coon42/magic-lantern-dev-kit/README.md

# magic-lantern-dev-kit
A dev kit for connection and communication with the service port of Canon EOS cameras.
