coon42/magic-lantern-dev-kit/dev_board/bom.xlsx

Item | Quantity | Reference | Manufacturer | DigiKey Distrib. Part # | Description
 | 14 | C1, C2, C4, C6, C7, C8, C9, C10, C11, C12, C13, C14, C17, C18 |  | 399-1170-1-ND | 100nF
 | 2 | C3, C5 |  | 399-C0805C300M5HAC7800CT-ND | 30pF
 | 2 | C15, C16 |  | T491A475K006AT7280-ND | 4.7uF Tantalum
 | 3 | D1, D3, D5 |  | 350-2038-2-ND | Led Red
 | 2 | D2, D4 |  | 732-4986-1-ND | Led Green
 | 2 | FB1, FB2 |  | 445-1568-1-ND | 220R @ 100MHz
 | 1 | J1 |  | SAM12233-ND | 01x05 2.54mm pin header (JTAG)
 | 1 | J2 |  | 732-5395-ND | 02x04 2.54mm IDC header (service cable connector)
 | 1 | J3 |  | SAM8952-ND | USB B Mini
 | 1 | J4 |  | A122210-ND | 01x08 2.54mm pin header (Probe Connector)
 | 1 | J5 |  | 609-3486-2-ND | 02x08 2.54mm SMD pin header (Jumper terminal)
 | 1 | Q1 |  | IRLML5203TRPBFCT-ND | IRLML5203 P channel Mosfet (for status LED)
 | 4 | R1, R2, R3, R8 |  | 2019-RK73B2ATTD103JCT-ND | 10K
 | 1 | R4 |  | 2019-RK73B2ATTD223JCT-ND | 22K
 | 1 | R5 |  | 2019-RK73B2ATTD123JCT-ND | 12K
 | 3 | R6, R13, R15 |  | 2019-RK73H2ATTD1001FTR-ND | 1K
 | 1 | R7 |  | 2019-RK73B2ATTD104JCT-ND | 100K
 | 5 | R9, R10, R11, R12, R14 |  | 2019-RK73B2ATTD331JTR-ND | 330R
 | 2 | U1, U2 |  | 296-34900-1-ND | SN74AUP1T34DCK Logic Level Translator
 | 1 | U3 |  | 93LC56BT-I/OTCT-ND | 93LCxxBxxOT EEPROM
 | 1 | U4 |  | 497-1242-1-ND | LD1117S33TR_SOT223 3.3V linear regulator
 | 1 | U5 |  | 768-1026-1-ND | FT4232HL Quad FTDI
 | 1 | U6 |  | 296-23258-1-ND | 74HC595 shift register
 | 1 | Y1 |  | 887-1720-1-ND | 12Mhz crystal oscillator
