coon42/magic-lantern-dev-kit/dev_board/ml_dev_board.kicad_pcb

## KiCad design dev_board/ml_dev_board.kicad_pcb (2026-02-09)

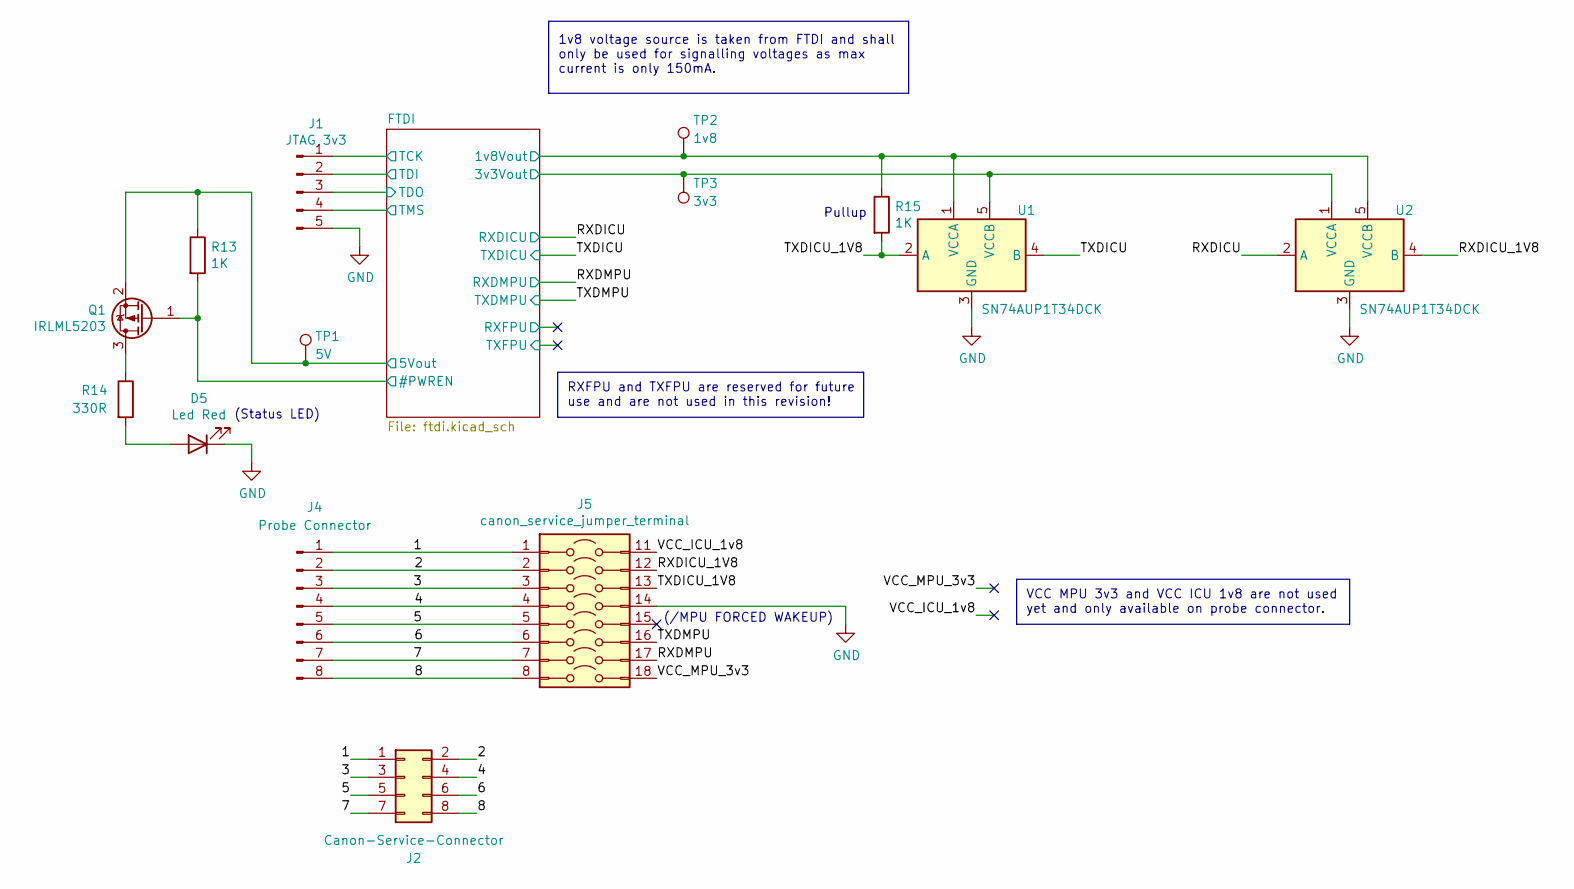
[picture p1: schematic ml_dev_board.kicad_sch]

Parts:
D5: Led Red; LED_0805_2012Metric
J1: JTAG 3v3; PinHeader_1x05_P2.54mm_Vertical_SMD_Pin1Left
J2: Canon-Service-Connector; IDC-Header_2x04_P2.54mm_Vertical
J4: Probe Connector; PinHeader_1x08_P2.54mm_Vertical_SMD_Pin1Left
J5: canon_service_jumper_terminal; PinHeader_2x08_P2.54mm_Vertical_Jumper_SMD
Q1: IRLML5203; SOT-23
R13, R15: 1K; R_0805_2012Metric
R14: 330R; R_0805_2012Metric
TP1: 5V; TestPoint_Pad_D1.5mm
TP2: 1v8; TestPoint_Pad_D1.5mm
TP3: 3v3; TestPoint_Pad_D1.5mm
U1, U2: SN74AUP1T34DCK; SOT-353_SC-70-5

Connections:
+1V8: R15.1, TP2.1, U1.1 (VCCA), U2.5 (VCCB); also elsewhere on the board
+3V3: TP3.1, U1.5 (VCCB), U2.1 (VCCA); also elsewhere on the board
+5V: Q1.2 (S), R13.1, TP1.1; also elsewhere on the board
/1: J2.1, J4.1, J5.1
/2: J2.2, J4.2, J5.2
/3: J2.3, J4.3, J5.3
/4: J2.4, J4.4, J5.4
/5: J2.5, J4.5, J5.5
/6: J2.6, J4.6, J5.6
/7: J2.7, J4.7, J5.7
/8: J2.8, J4.8, J5.8
/FTDI/#PWREN: Q1.1 (G), R13.2; also elsewhere on the board
/FTDI/TCK: J1.1; also elsewhere on the board
/FTDI/TDI: J1.2; also elsewhere on the board
/FTDI/TDO: J1.3; also elsewhere on the board
/FTDI/TMS: J1.4; also elsewhere on the board
/RXDICU: U2.2 (A); also elsewhere on the board
/RXDICU_1V8: J5.12, U2.4 (B)
/RXDMPU: J5.17; also elsewhere on the board
/TXDICU: U1.4 (B); also elsewhere on the board
/TXDICU_1V8: J5.13, R15.2, U1.2 (A)
/TXDMPU: J5.16; also elsewhere on the board
/VCC_ICU_1v8: J5.11
/VCC_MPU_3v3: J5.18
GND: D5.1 (K), J1.5, J5.14, U1.3 (GND), U2.3 (GND); also elsewhere on the board
unnamed: D5.2 (A), R14.2
unnamed: Q1.3 (D), R14.1

Notes on the sheet:
Pullup
RXFPU and TXFPU are reserved for future use and are not used in this revision!
(/MPU FORCED WAKEUP)
(Status LED)
1v8 voltage source is taken from FTDI and shall only be used for signalling voltages as max current is only 150mA.
VCC MPU 3v3 and VCC ICU 1v8 are not used yet and only available on probe connector.

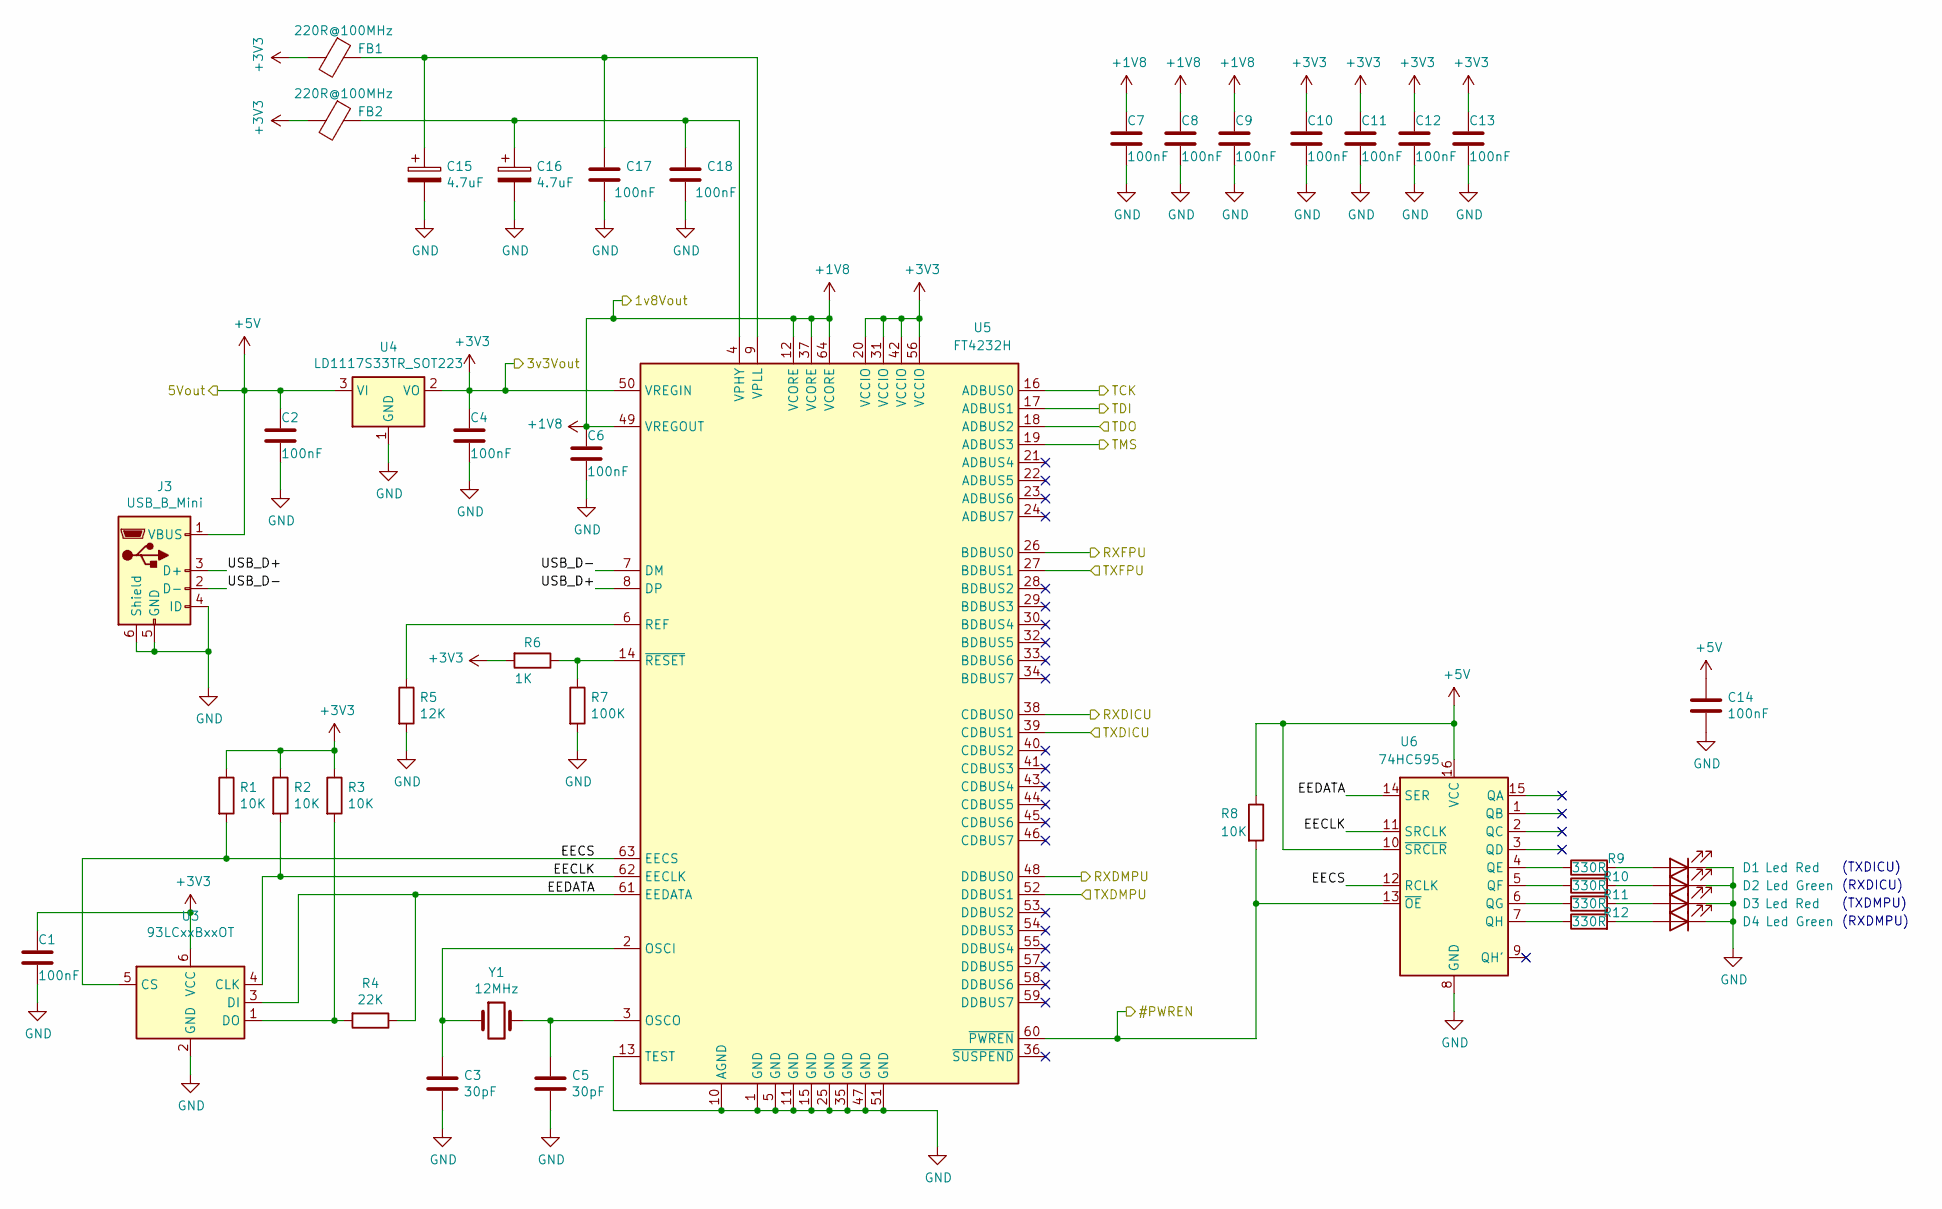
[picture p2: schematic ftdi.kicad_sch]

Parts:
C1, C2, C4, C6, C7, C8, C9, C10, C11, C12, C13, C14, C17, C18: 100nF; C_0805_2012Metric
C3, C5: 30pF; C_0805_2012Metric
C15, C16: 4.7uF; CP_EIA-3216-18_Kemet-A
D1, D3: Led Red; LED_0805_2012Metric
D2, D4: Led Green; LED_0805_2012Metric
FB1, FB2: 220R@100MHz; L_0805_2012Metric
J3: USB_B_Mini; USB_Mini-B_Lumberg_2486_01_Horizontal
R1, R2, R3, R8: 10K; R_0805_2012Metric
R4: 22K; R_0805_2012Metric
R5: 12K; R_0805_2012Metric
R6: 1K; R_0805_2012Metric
R7: 100K; R_0805_2012Metric
R9, R10, R11, R12: 330R; R_0805_2012Metric
U3: 93LCxxBxxOT; SOT-23-6
U4: LD1117S33TR_SOT223; SOT-223-3_TabPin2
U5: FT4232H; LQFP-64-1EP_10x10mm_P0.5mm_EP6.5x6.5mm_no_central_solder_pad
U6: 74HC595; TSSOP-16_4.4x5mm_P0.65mm
Y1: 12MHz; Crystal_SMD_TXC_7M-4Pin_3.2x2.5mm

Connections:
+1V8: C6.1, C7.1, C8.1, C9.1, U5.12 (VCORE), U5.37 (VCORE), U5.49 (VREGOUT), U5.64 (VCORE); also elsewhere on the board
+3V3: C1.1, C4.1, C10.1, C11.1, C12.1, C13.1, FB1.2, FB2.2, R1.1, R2.1, R3.1, R6.2, U3.6 (VCC), U4.2 (VO), U5.20 (VCCIO), U5.31 (VCCIO), U5.42 (VCCIO), U5.50 (VREGIN), U5.56 (VCCIO); also elsewhere on the board
+5V: C2.1, C14.1, J3.1 (VBUS), R8.1, U4.3 (VI), U6.10 (~SRCLR), U6.16 (VCC); also elsewhere on the board
/FTDI/#PWREN: R8.2, U5.60 (~PWREN), U6.13 (~OE); also elsewhere on the board
/FTDI/EECLK: R2.2, U3.4 (CLK), U5.62 (EECLK), U6.11 (SRCLK)
/FTDI/EECS: R1.2, U3.5 (CS), U5.63 (EECS), U6.12 (RCLK)
/FTDI/EEDATA: R4.1, U3.3 (DI), U5.61 (EEDATA), U6.14 (SER)
/FTDI/RXFPU: U5.26 (BDBUS0)
/FTDI/TCK: U5.16 (ADBUS0); also elsewhere on the board
/FTDI/TDI: U5.17 (ADBUS1); also elsewhere on the board
/FTDI/TDO: U5.18 (ADBUS2); also elsewhere on the board
/FTDI/TMS: U5.19 (ADBUS3); also elsewhere on the board
/FTDI/TXFPU: U5.27 (BDBUS1)
/FTDI/USB_D+: J3.3 (D+), U5.8 (DP)
/FTDI/USB_D-: J3.2 (D-), U5.7 (DM)
/RXDICU: U5.38 (CDBUS0); also elsewhere on the board
/RXDMPU: U5.48 (DDBUS0); also elsewhere on the board
/TXDICU: U5.39 (CDBUS1); also elsewhere on the board
/TXDMPU: U5.52 (DDBUS1); also elsewhere on the board
GND: C1.2, C2.2, C3.2, C4.2, C5.2, C6.2, C7.2, C8.2, C9.2, C10.2, C11.2, C12.2, C13.2, C14.2, C15.2, C16.2, C17.2, C18.2, D1.1 (K), D2.1 (K), D3.1 (K), D4.1 (K), J3.4 (ID), J3.5 (GND), J3.6 (Shield), R5.2, R7.2, U3.2 (GND), U4.1 (GND), U5.1 (GND), U5.5 (GND), U5.10 (AGND), U5.11 (GND), U5.13 (TEST), U5.15 (GND), U5.25 (GND), U5.35 (GND), U5.47 (GND), U5.51 (GND), U6.8 (GND); also elsewhere on the board
unnamed: D1.2 (A), R9.2
unnamed: D2.2 (A), R10.2
unnamed: D3.2 (A), R11.2
unnamed: D4.2 (A), R12.2
unnamed: R3.2, R4.2, U3.1 (DO)
unnamed: C3.1, U5.2 (OSCI), Y1.1
unnamed: C5.1, U5.3 (OSCO), Y1.2
unnamed: R5.1, U5.6 (REF)
unnamed: C16.1, C18.1, FB2.1, U5.4 (VPHY)
unnamed: C15.1, C17.1, FB1.1, U5.9 (VPLL)
unnamed: R6.1, R7.1, U5.14 (~RESET)
unnamed: R9.1, U6.4 (QE)
unnamed: R10.1, U6.5 (QF)
unnamed: R11.1, U6.6 (QG)
unnamed: R12.1, U6.7 (QH)

Notes on the sheet:
(RXDMPU)
(RXDICU)
(TXDICU)
(TXDMPU)

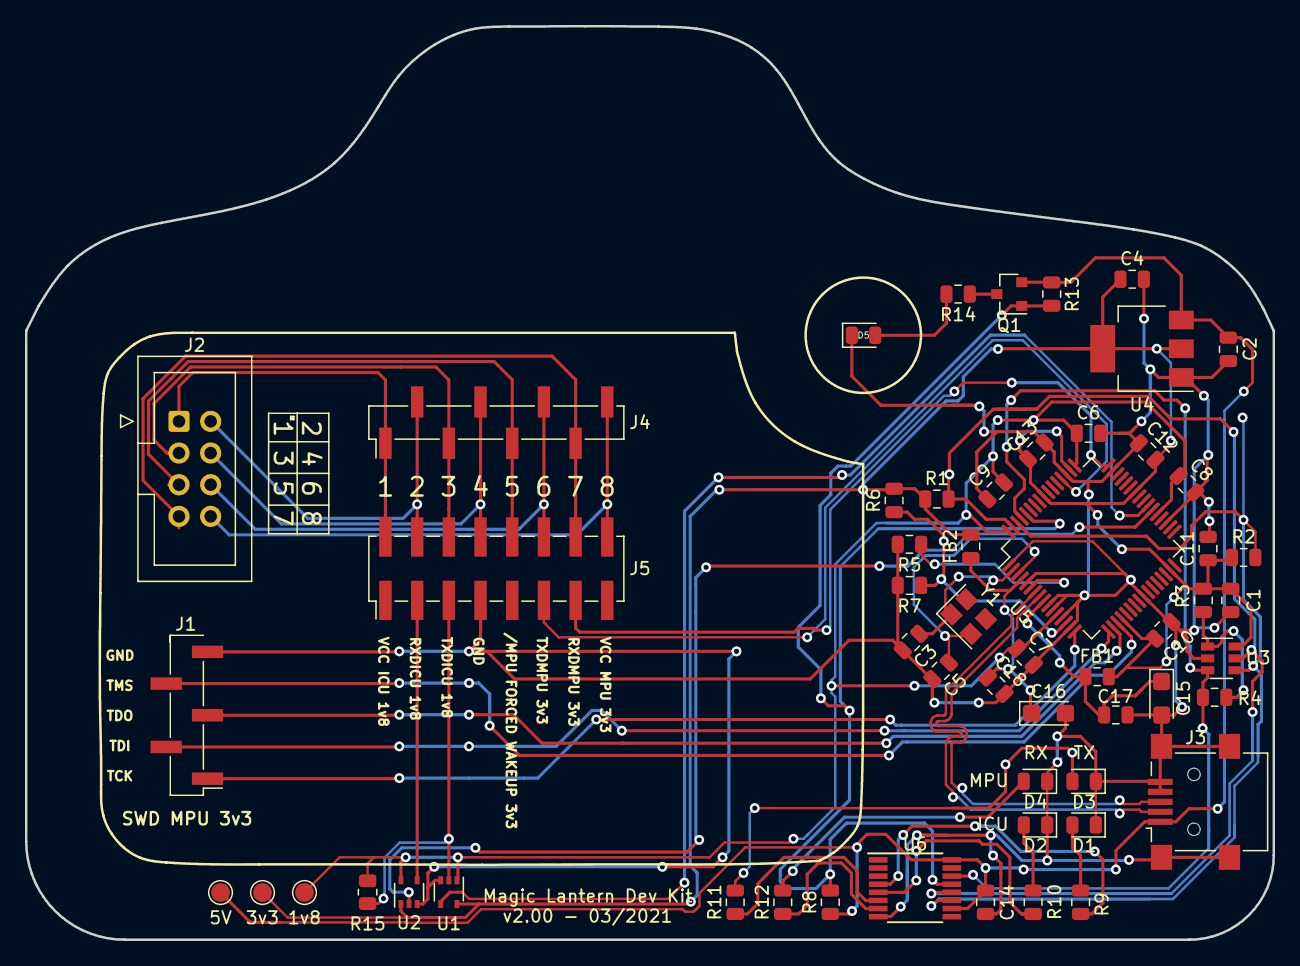
[picture p3: board ml_dev_board.kicad_pcb from above]

Board: 2 copper layers, 100.0 x 73.2 mm, 56 parts (0 on the bottom side), 45 nets.
