coon42/magic-lantern-dev-kit/cable/13pin/canon-service-cable.kicad_pcb

## KiCad design cable/13pin/canon-service-cable.kicad_pcb (2025-09-07)

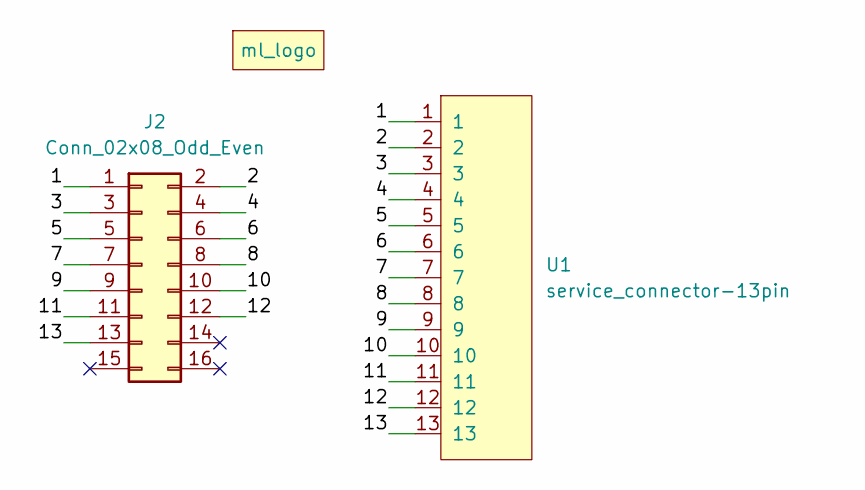
[picture p4: schematic canon-service-cable.kicad_sch]

Parts:
G1: ml_logo; logo
J2: Conn_02x08_Odd_Even; IDC-Header_2x08_P2.54mm_Horizontal
U1: service_connector-13pin; service_connector_pads_13pin

Connections:
/1: J2.1, U1.1
/2: J2.2, U1.2
/3: J2.3, U1.3
/4: J2.4, U1.4
/5: J2.5, U1.5
/6: J2.6, U1.6
/7: J2.7, U1.7
/8: J2.8, U1.8
/9: J2.9, U1.9
/10: J2.10, U1.10
/11: J2.11, U1.11
/12: J2.12, U1.12
/13: J2.13, U1.13

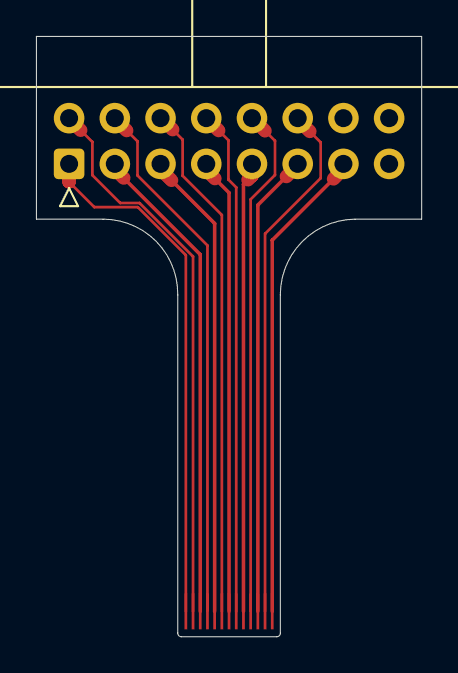
[picture p5: board cable/13pin/canon-service-cable.kicad_pcb from above]

Board: 2 copper layers, 21.4 x 33.4 mm, 3 parts (1 on the bottom side), 13 nets.
