coon42/magic-lantern-dev-kit/cable/8pin/canon-service-cable.kicad_pcb

## KiCad design cable/8pin/canon-service-cable.kicad_pcb (2025-09-06, an earlier design)

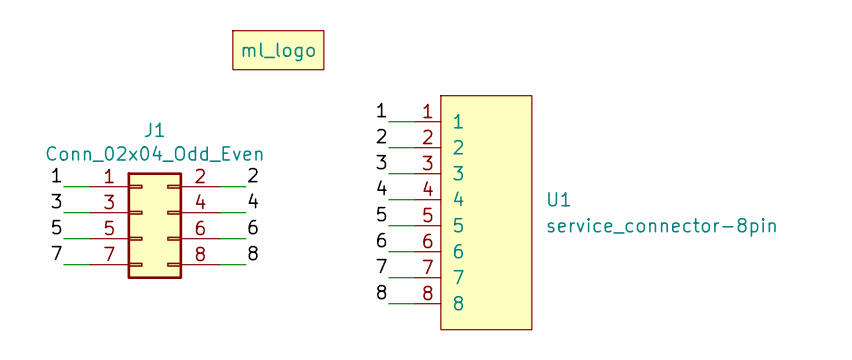
[picture p6: schematic canon-service-cable.kicad_sch]

Parts:
G1: ml_logo; logo
J1: Conn_02x04_Odd_Even; IDC-Header_2x04_P2.54mm_Horizontal
U1: service_connector-8pin; service_connector_pads_8pin

Connections:
/1: J1.1, U1.1
/2: J1.2, U1.2
/3: J1.3, U1.3
/4: J1.4, U1.4
/5: J1.5, U1.5
/6: J1.6, U1.6
/7: J1.7, U1.7
/8: J1.8, U1.8

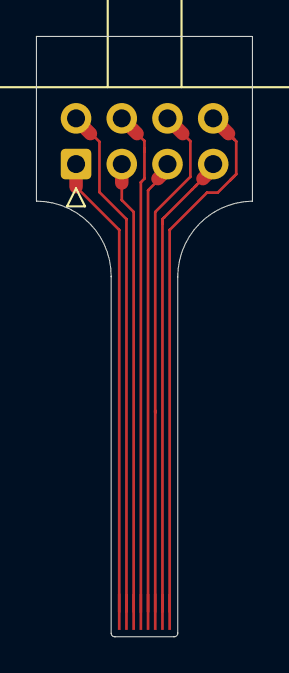
[picture p7: board cable/8pin/canon-service-cable.kicad_pcb from above]

Board: 2 copper layers, 12.0 x 33.4 mm, 3 parts (1 on the bottom side), 8 nets.
