coon42/magic-lantern-dev-kit/(threads)

Thread 1 (2020-12-15):

Status LED is too bright

coon42, 2020-12-15:
Status LED works as intended but is a little bit to bright. Therefore the 200 Ohms current limiting resistor should be incrased.
Maybe to 400 Ohms.

Thread 2 (2020-12-15):

RXMPU pin is wrong

coon42, 2020-12-15:
RXMPU is on pin 7 instead of Pin 5.

coon42, 2020-12-16:
fixed

Closed 2020-12-16.

Thread 4 (2020-12-15):

Add Optional RX/TX probing terminal with current limiting resistor + make signal voltage selectable

coon42, 2020-12-15:
To probe RX/TX pins on new camera models some "protected pins" could be added to one of the UART RX/TX pins. One candidate could be the JTAG connector.

The signalling voltage of that pins could be selectable between 1.8V and 3.3V and could also get a current limiting resistor of 4k7 to avoid of frying something by connecting the probe TX pin and a camera TX pin.

Thread 5 (2020-12-15):

Pullup resistor is missing on 1v8 pin of TXICU.

coon42, 2020-12-15:
TXICU pin is floating when unconnected and leads to receiving garbe on the FTDI. A pullup resistor needs to be added on 1v8 input side of the level shifter to fix that.

coon42, 2020-12-16:
fixed

Closed 2020-12-16.

Thread 6 (2020-12-15):

Some parts on the BOM do not fit

coon42, 2020-12-15:
- Probe connector pitch is wrong. It is 2.00mm but needs to be 2.54mm
- Jumper terminal has only 4 pins but needs to have 8 pins.

coon42, 2020-12-16:
fixed.

Closed 2020-12-16.
