coon42/magic-lantern-dev-kit/(commit log)

2020-09-26 add kicad project of cable
    [canon-service-cable.kicad_pcb, canon-service-cable.sch]
2020-10-21 cable: adjust pad height from 3mm to 2.5mm
2020-10-21 cable: adjust connector width from 2.6mm to 2.7mm
    [canon-service-cable.kicad_pcb]
2020-10-21 add dev_board project
    [ftdi.sch, ml_dev_board.kicad_pcb, ml_dev_board.sch]
2020-10-22 dev_board: add status led + test pads
    [ftdi.sch, ml_dev_board.kicad_pcb, ml_dev_board.sch]
2020-10-22 dev_board: add missing status LED resistor + fix silk
    [ml_dev_board.kicad_pcb, ml_dev_board.sch]
2020-10-24 dev_board: use tantalum footprints for polarized caps
    [ftdi.sch, ml_dev_board.kicad_pcb]
2020-10-24 dev_board: fix service connector pinout / use straight connector + cosmetics
    [ftdi.sch, ml_dev_board.kicad_pcb, ml_dev_board.sch]
2020-11-30 dev_board: use correct footprint for tantalum caps
    [ftdi.sch, ml_dev_board.kicad_pcb]
2020-11-30 cable: replace angled pin header by angled IDC header
    [canon-service-cable.kicad_pcb, canon-service-cable.sch]
2020-11-30 dev_board: add BOM
    [bom.xlsx]
2020-11-30 Release: canon-service-cable v1.0
    [canon-service-cable.kicad_pcb]
2020-11-30 cable: add v1.0 gerber files
    [canon-service-cable-B_Cu.gbl, canon-service-cable-B_Mask.gbs, canon-service-cable-B_SilkS.gbo, canon-service-cable-Edge_Cuts.gm1, canon-service-cable-F_Cu.gtl, canon-service-cable-F_Mask.gts, canon-service-cable-F_SilkS.gto, canon-service-cable-NPTH.drl]
2020-11-30 dev-board: add v1.0 gerber files
    [ml_dev_board-B_Cu.gbl, ml_dev_board-B_Mask.gbs, ml_dev_board-B_Paste.gbp, ml_dev_board-B_SilkS.gbo, ml_dev_board-Edge_Cuts.gm1, ml_dev_board-F_Cu.gtl, ml_dev_board-F_Mask.gts, ml_dev_board-F_Paste.gtp]
2020-12-16 dev board: fix wrong parts on BOM
    [bom.xlsx]
2020-12-16 dev board: fix mini usb symbol
    [ftdi.sch, ml_dev_board.kicad_pcb]
2020-12-16 dev board: jumper terminal: move RXMPU from pin 5 to pin 7
    [ml_dev_board.kicad_pcb, ml_dev_board.sch]
2020-12-16 dev board: add 1v8 pullup resistor to TXICU pin
    [ml_dev_board.kicad_pcb, ml_dev_board.sch]
2020-12-16 dev board: fix silk screen for pin 5 and pin 7 (RXMPU)
    [ml_dev_board.kicad_pcb]
2020-12-16 dev board: align ICU and MPU silk screen
    [ml_dev_board.kicad_pcb]
2020-12-16 dev board: add RXMPU 1K pullup resistor to BOM
    [bom.xlsx]
2020-12-16 dev board: rename JTAG 3.3V to JTAG 3v3
    [ml_dev_board.kicad_pcb, ml_dev_board.sch]
2020-12-16 dev board: route unconnected ground pin
    [ml_dev_board.kicad_pcb]
2020-12-16 dev board: align TX and RX silk screen
    [ml_dev_board.kicad_pcb]
2021-03-05 dev board: updated something on the bom
    [bom.xlsx]
2021-03-05 dev board: added VCC ICU 1v8 + VCC MPU 3v3
    [ml_dev_board.kicad_pcb, ml_dev_board.sch]
2021-03-05 dev board: pcb: 3.3V -> 3v3, 1.8V -> 1v8
    [ml_dev_board.kicad_pcb]
2021-03-05 dev board: pcb: update version number to v2.0
    [ml_dev_board.kicad_pcb]
2021-12-10 dev board: ftdi: 3.3v -> 3v3
    [ftdi.sch, ml_dev_board.sch]
2021-12-10 dev board: add 1v8 max current warning
    [ml_dev_board.sch]
2022-03-05 add Kicad 5 project files
2022-03-05 cable: round up corners on connector
    [canon-service-cable.kicad_pcb, canon-service-cable.kicad_sch]
2022-03-05 cable: shorten contact pads a bit
    [canon-service-cable.kicad_pcb]
2022-03-05 cable: update gerber files
    [canon-service-cable-B_Cu.gbl, canon-service-cable-B_Mask.gbs, canon-service-cable-B_SilkS.gbo, canon-service-cable-B_Silkscreen.gbo, canon-service-cable-Edge_Cuts.gm1, canon-service-cable-F_Cu.gtl, canon-service-cable-F_Mask.gts, canon-service-cable-F_Silkscreen.gto]
2023-06-12 update kicad version
    [canon-service-cable.kicad_pcb, canon-service-cable.kicad_sch, ftdi.kicad_sch, ml_dev_board.kicad_pcb, ml_dev_board.kicad_sch]
2025-09-06 move cable project files to 8pin subdir
2025-09-06 canon-service-cable: migrate kicad project to Kicad 9.0.4 + remove legacy project files
2025-09-06 canon-service-cable: rename footprint: canon-service-cable:service_connector_pads -> canon-service-cable:service_connector_pads_8pin
2025-09-06 canon-service-cable: migrate canon.lib -> canon.kicad_sym
2025-09-06 canon-service-cable: move footprints and symbols dir to parent dir
2025-09-06 canon-service-cable: 8pin: align pads to origin
2025-09-06 canon-service-cable: add footprint for 13pin cable
2025-09-06 canon-service-cable: add symbol for 13pin cable
2025-09-06 canon-service-cable: add project for 13 pin cable connector
2025-09-06 canon-service-cable: add gerber files for 13 pins variant
2025-09-07 cable: 13pin: add stiffner
2026-02-09 dev_board: update kicad project file + add MPU FORCED WAKEUP pin
2026-02-09 dev_board: pcb: rename JTAG 3v3 -> SWD MPU 3v3
